Roldao-Neto/Vision_Based_AGV/sketch/src/config/config.h

// Constants shared by the modules: pins, tick period, path and arena limits.
#pragma once

#include <Arduino.h>
#include "../encoder_guard/encoder_guard.h"
#include "../follower/follower.h"
#include "../odometry/odometry.h"
#include "../wheel_pi/wheel_pi.h"

namespace config
{
    enum Wheel { kLeft = 0, kRight = 1 };

    constexpr uint32_t kPwmHz = 20000;

    // TB6612 pins (wiring: docs/diagrama-ligacoes.svg)
    constexpr int kLeftPwm = D6;
    constexpr int kLeftIn1 = D7;
    constexpr int kLeftIn2 = D8;
    constexpr int kRightPwm = D9;
    constexpr int kRightIn1 = D10;
    constexpr int kRightIn2 = D11;

    // Encoders, x4 quadrature (A and B on interrupts)
    constexpr int kLeftEncA = D2;  // PB3
    constexpr int kLeftEncB = D4;  // PA12
    constexpr int kRightEncA = D3; // PB0
    constexpr int kRightEncB = D5; // PA11

    // Right motor reversed: "mirrored" -> Measured to be sure which one was the "default"
    constexpr bool kLeftMotorReversed = false;
    constexpr bool kRightMotorReversed = true;
    constexpr bool kLeftEncReversed = false;
    constexpr bool kRightEncReversed = true;

    // Paths: 1 to 32 absolute axle waypoints in integer mm
    constexpr int kMaxWaypoints = follower::kMaxWaypoints;
    constexpr int32_t kArenaXMm = 2000;
    constexpr int32_t kArenaYMm = 1500;

    constexpr float kCountsPerRev = 1319.75f; // mean of 3 count-mode runs of 10 turns samples
    constexpr float kWheelDiameterM = 0.0675f;

    // Odometry: m per count per wheel and track b, calibrated on the Day 2 bench (docs/logs/day2-bench.md)
    constexpr double kMetersPerCountNominal = 3.14159265358979 * (double)kWheelDiameterM / (double)kCountsPerRev;
    constexpr double kScaleEs = 0.98103; // S1: mean real / mean odometry distance of 5 straight runs
    constexpr double kMetersPerCount = kMetersPerCountNominal * kScaleEs;
    // U1 (UMBmark, 5 CW + 5 CCW): Ed = 1.00176 sets c_L, c_R (their mean stays 1), Eb = 0.99575
    constexpr double kCorrLeft = 0.99912;
    constexpr double kCorrRight = 1.00088;
    constexpr double kTrackEb = 0.99575;
    constexpr double kTrackM = 0.217 * kTrackEb;
    constexpr odometry::Config kOdometry = {
        {kMetersPerCount * kCorrLeft, kMetersPerCount * kCorrRight},
        kTrackM
    };

    // Control tick
    constexpr uint32_t kTickPeriodUs = 20000;
    constexpr uint32_t kReportEveryTicks = 25; // status every 500 ms
    constexpr uint32_t kPoseEveryTicks = 2;    // pose at 25 Hz

    // Encoder guard (closed loop): |duty| >= 20 % for 10 ticks (200 ms) without a count ends the mode at once, coasting
    constexpr encoder_guard::Config kEncoderGuard = {0.2f, 10};

    constexpr float kSpeedTcl = 0.1f;         // s, closed-loop time constant
    constexpr float kSpeedMaxDuty = 0.5f;     // closed-loop duty limit
    constexpr float kSpeedMinMps = 0.005f;    // below it the w coasts ("a few mm/s")
    constexpr float kStopDecelMps2 = 0.5f;    // speed ramps and every planned stop

    // K in counts/s per unit duty, tau in s, pwm0 = start of sustained motion on the ramp.
    constexpr wheel_pi::Model kLeftFwd = {7160.4f, 0.15362f, 0.074f};
    constexpr wheel_pi::Model kLeftBwd = {6668.3f, 0.14667f, 0.088f};
    constexpr wheel_pi::Model kRightFwd = {7271.4f, 0.10906f, 0.069f};
    constexpr wheel_pi::Model kRightBwd = {7509.1f, 0.14285f, 0.072f};

    // v_min in counts/s with each wheel's own m/count
    constexpr wheel_pi::Config kLeftPi = {
        kLeftFwd,
        kLeftBwd,
        kSpeedTcl,
        kSpeedMaxDuty,
        (float)((double)kSpeedMinMps / kOdometry.m_per_count[kLeft])
    };

    constexpr wheel_pi::Config kRightPi = {
        kRightFwd,
        kRightBwd,
        kSpeedTcl, 
        kSpeedMaxDuty,
        (float)((double)kSpeedMinMps / kOdometry.m_per_count[kRight])
    };

    constexpr uint32_t kStoppedTicks = 2; // ticks without a count on either wheel = stopped

    // Point-to-point controller (docs/logs/day3-firmware.md). The heading PI is the Day 2 design
    // (docs/logs/day2-firmware.md, item 2): Kp 1/s, Ti s, steering limit rad/s. Turns go up to
    // 90°/s at α = 2a/b, so each wheel also accelerates and brakes at a.
    constexpr follower::Config kFollower = {
        0.25f,                                             // cruise, m/s
        kStopDecelMps2,                                    // accel, m/s²
        1.5707963f,                                        // turn_max, rad/s
        (float)(2.0 * (double)kStopDecelMps2 / kTrackM),   // turn_accel, rad/s²
        0.015f,                                            // steer_stop, m
        0.05235988f,                                       // heading_stop, 3°
        0.10f,                                             // freeze, m
        0.5235988f,                                        // realign, 30°
        1.0f,                                              // look, s: 3 frames at ~5 frames/s, ~0.25 s old: ~0.85 s
        {2.3f, 1.0f, 0.5f},                                // heading PI
    };

    // No hb for this long brakes the robot and ends the path
    constexpr uint32_t kHeartbeatTimeoutMs = 1000;
    // reset_pose: |θ| ≤ π
    constexpr int32_t kMaxThetaMrad = 3142;
}
