Roldao-Neto/Vision_Based_AGV/(commit log)

2026-10-14 Added firmware + calibration code + analysis
2026-10-28 Updated camera for dataset collection
2026-10-30 2.5 cm grid, 1 cm margin and two obstacle clearances (straight != turn), start cell free when robot can turn there
2026-10-31 Changed box class to multiple cones, bug fixes in paths with more than 1 obstacle.
    [config.h, follower.cpp, follower.h]
